ZuluSCSI/ZuluSCSI-Blaster-Ultra-Lite-OSHW/README.md

ZuluSCSI® Blaster Ultra Lite OSHW
================

This repository contains the KiCAD 10 schematic and PCB design files for an Open Source Hardware variant of the RP2350B-based ZuluSCSI® Blaster 

ZuluSCSI® Ultra Lite OSHW is the worlds first* **_open-source**_ [OSHWA-certified](https://certification.oshwa.org/us002873.html) _Ultra_ SCSI emulator, an open-source alternative to our commercially available ZuluSCSI Blaster, designed with cost efficiency in mind.

ZuluSCSI® Blaster Ultra Lite runs unmodified [ZuluSCSI Blaster firmware](https://github.com/ZuluSCSI/ZuluSCSI-firmware/releases)

Pre-prepared gerbers and BoM files are available in [the release section](https://github.com/ZuluSCSI/ZuluSCSI-Blaster-Ultra-Lite-OSHW/releases/tag/Rev2026b)

License
----------------------------

This hardware design is licensed under the terms of the [strongly reciprocal CERN OHL-S V2 license](https://ohwr.org/cern_ohl_s_v2.txt) 

ZuluSCSI® is a registered trademark of Rabbit Hole Computing, and may not be used commercially without the express written consent of Rabbit Hole Computing. Individuals producing ZuluSCSI boards for personal use are hereby granted permission to use the ZuluSCSI trademark in a noncommercial capacity.

_Any_ use of the ZuluSCSI® [registered trademark](https://tmsearch.uspto.gov/search/search-results/97574699) in a **commercial** context requires **prior written consent from Rabbit Hole Computing.**

ZuluSCSI Blaster Ultra Lite OSHW

*That we know of :)
