ZuluSCSI/ZuluSCSI-Blaster-Ultra-Lite-OSHW/certification-mark-US002873-stacked.png

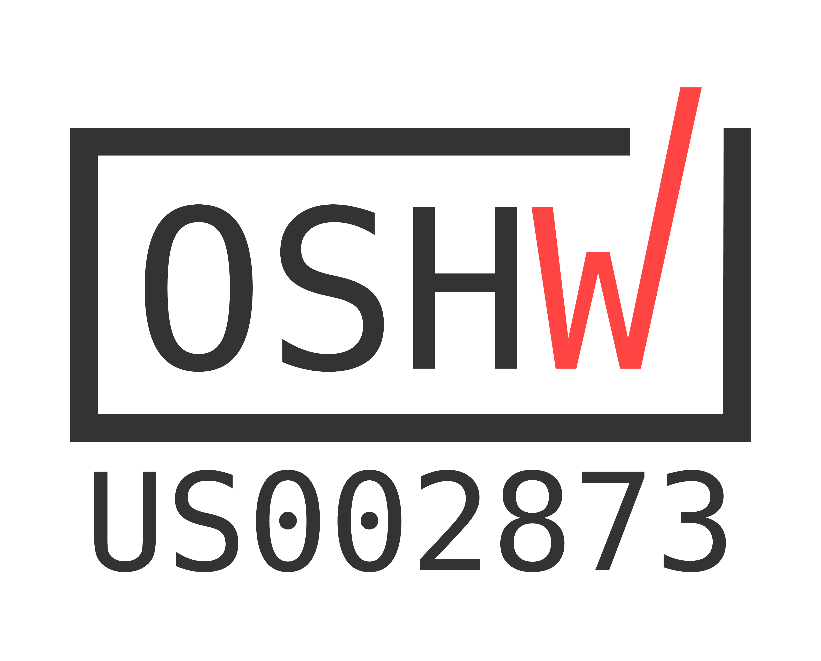
certification-mark-US002873-stacked.png
