ZuluSCSI/ZuluSCSI-Blaster-Ultra-Lite-OSHW/ZuluSCSI_Blaster_Ultra_Lite_OSHW_Rev2026b-render-bottom.png

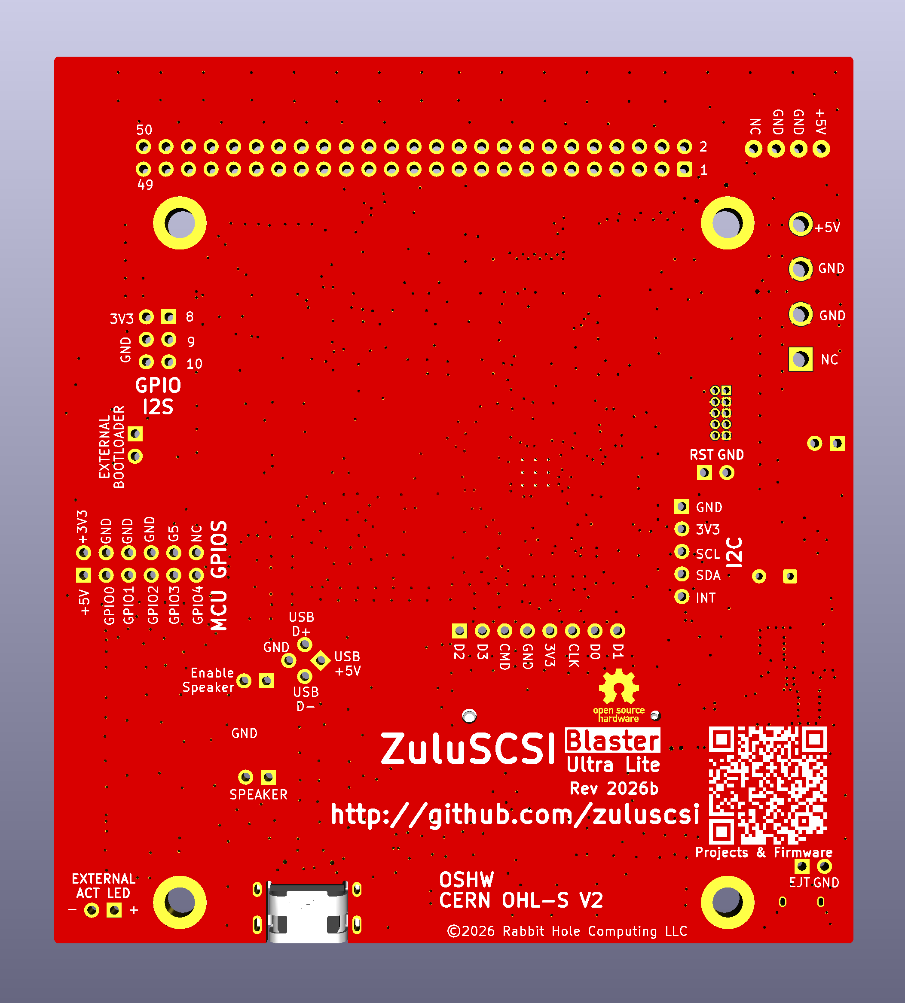
ZuluSCSI_Blaster_Ultra_Lite_OSHW_Rev2026b-render-bottom.png
