ZuluSCSI/ZuluSCSI-Blaster-Ultra-Lite-OSHW/kicad_libs/3D-models/c-3-1761605-5-b-3d.stp

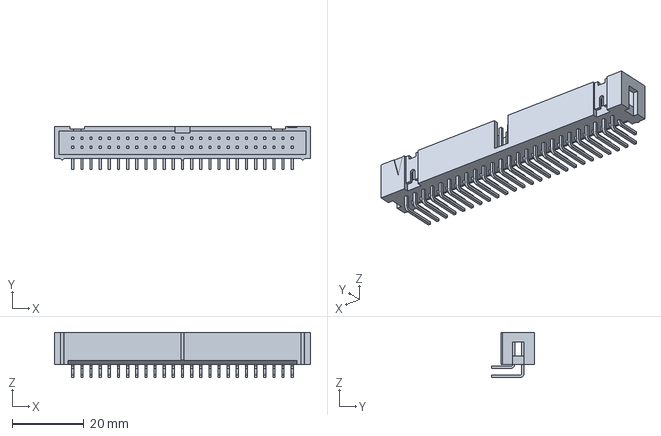
[picture p3: CAD file, 2026-11-06]
kicad_libs/3D-models/c-3-1761605-5-b-3d.stp
71.1 x 11.8 x 12.5 mm
