ZuluSCSI/ZuluSCSI-Blaster-Ultra-Lite-OSHW/kicad_libs/3D-models/RP2350_QFN80.step

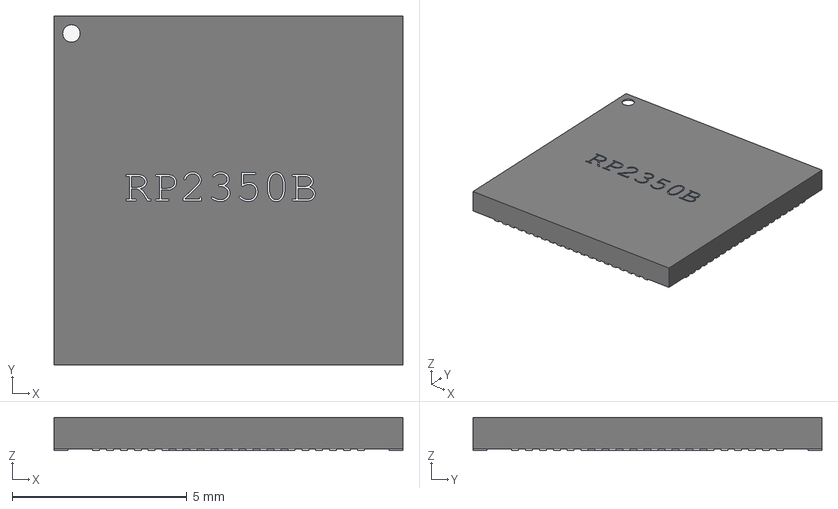
[picture p4: CAD file, 2026-11-06]
kicad_libs/3D-models/RP2350_QFN80.step
10.0 x 10.0 x 0.95 mm
