ZuluSCSI/ZuluSCSI-Blaster-Ultra-Lite-OSHW/kicad_libs/3D-models/molex-vert-c-350424-1-t-3d.stp

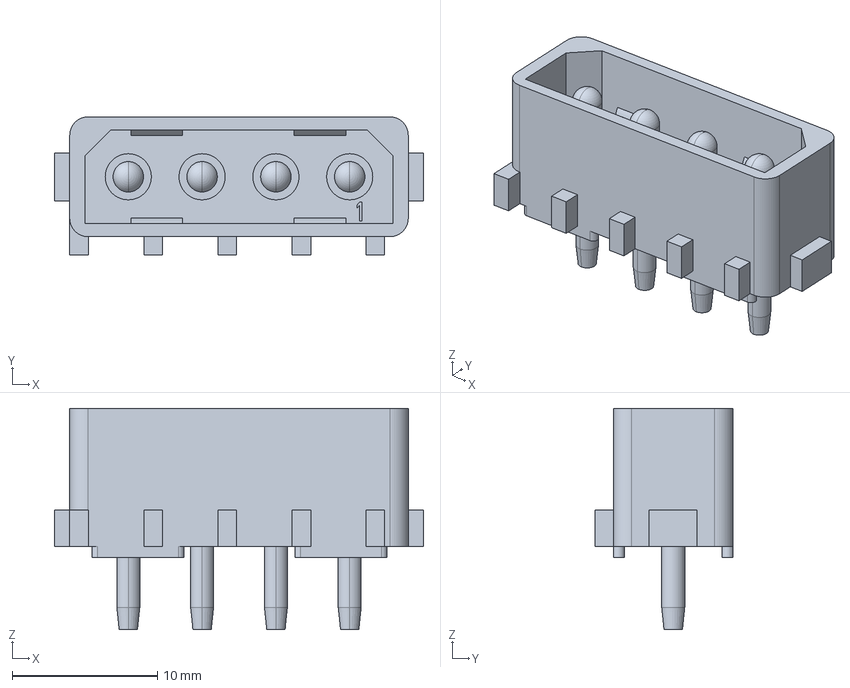
[picture p5: CAD file, 2026-11-06]
kicad_libs/3D-models/molex-vert-c-350424-1-t-3d.stp
25.4 x 9.53 x 15.2 mm
