ZuluSCSI/ZuluSCSI-Blaster-Ultra-Lite-OSHW/kicad_libs/3D-models/70543-0003.stp

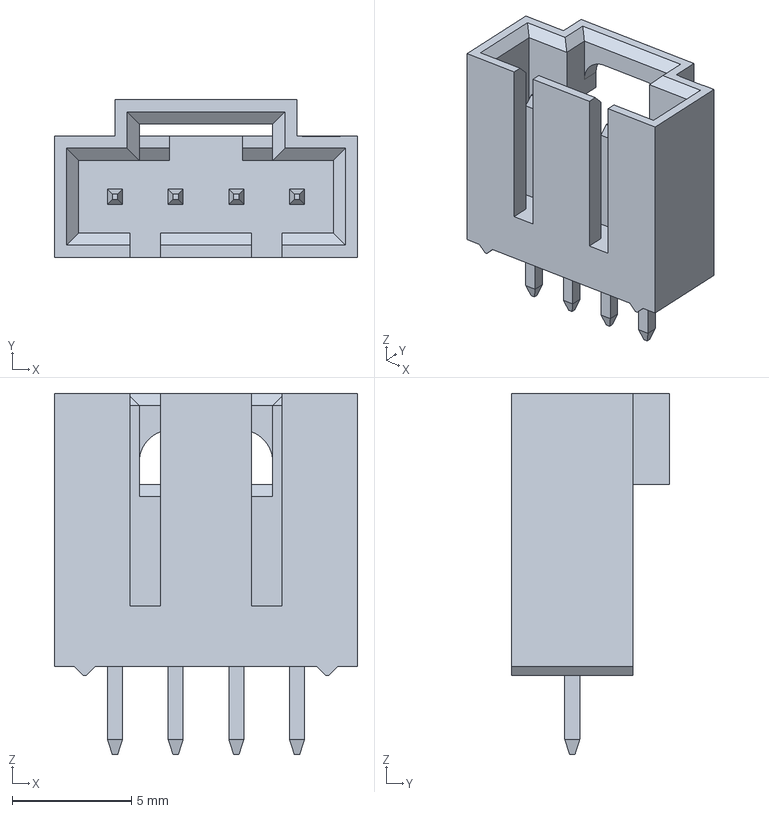
[picture p6: CAD file, 2026-11-06]
kicad_libs/3D-models/70543-0003.stp
12.7 x 6.60 x 15.1 mm
