ZuluSCSI/ZuluSCSI-Blaster-Ultra-Lite-OSHW/kicad_libs/3D-models/705530003.step

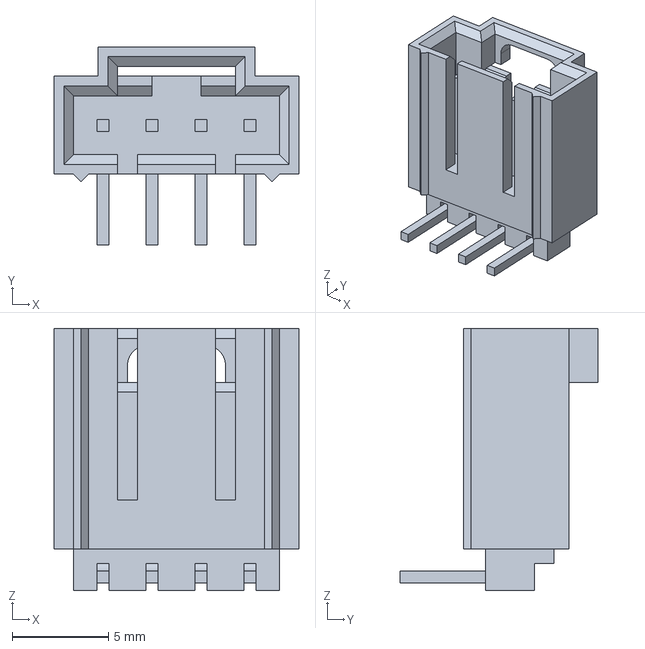
[picture p7: CAD file, 2026-11-06]
kicad_libs/3D-models/705530003.step
12.7 x 10.3 x 13.6 mm
