ZuluSCSI/ZuluSCSI-Blaster-Ultra-Lite-OSHW/ZuluSCSI_Blaster_Ultra_Lite.kicad_pcb

## KiCad design ZuluSCSI_Blaster_Ultra_Lite.kicad_pcb (2026-11-06)

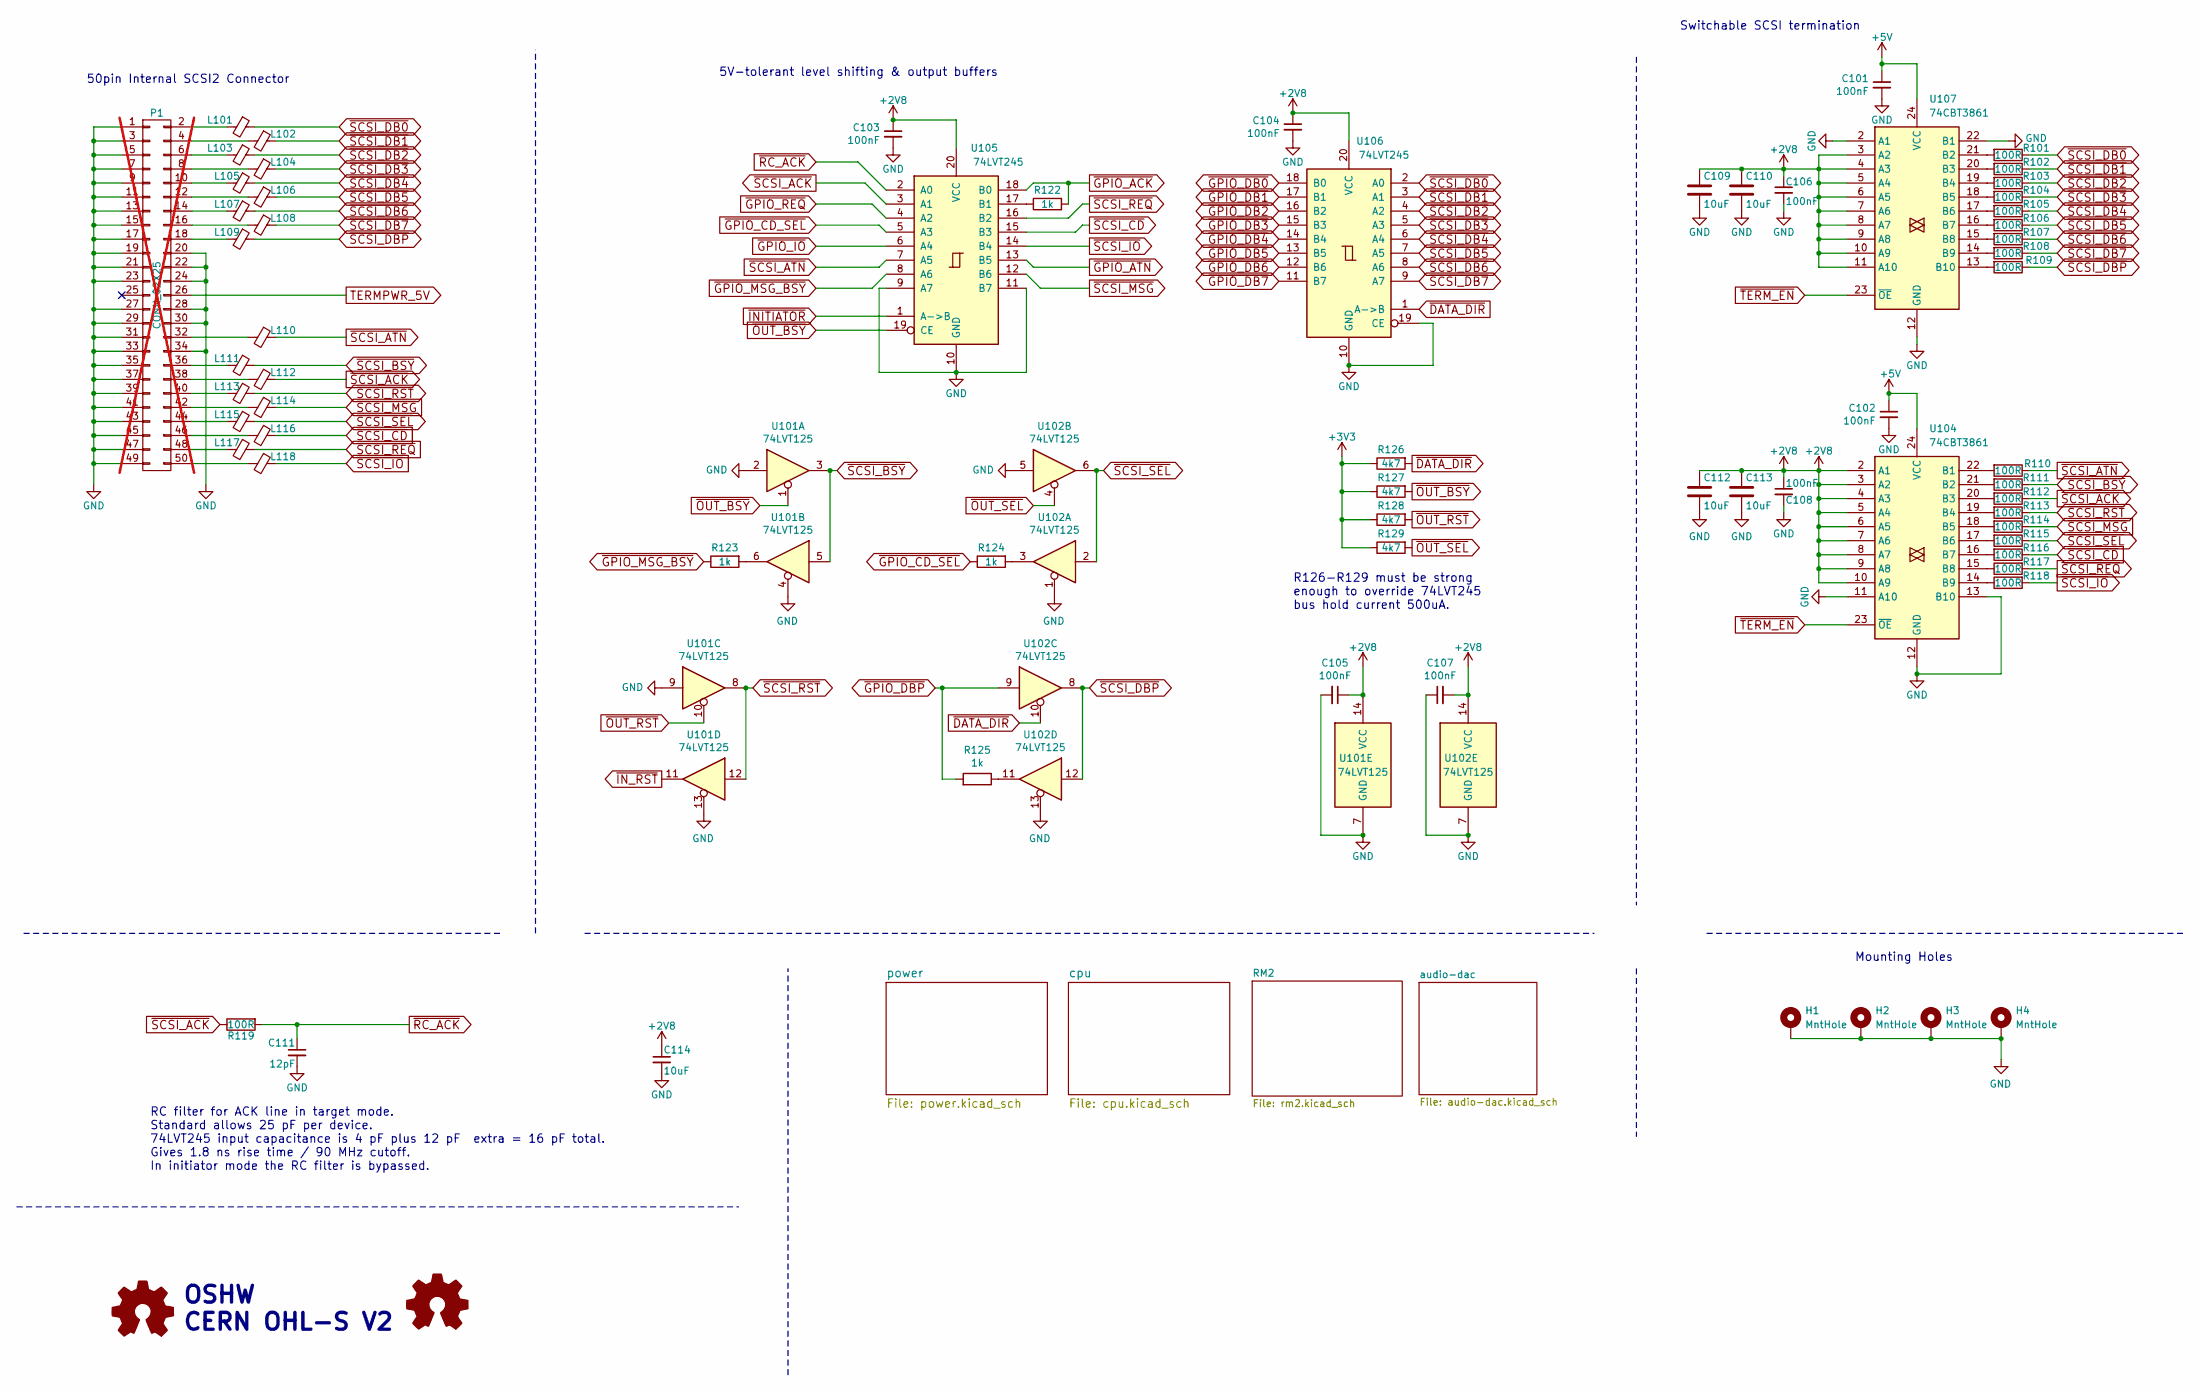
[picture p8: schematic ZuluSCSI_Blaster_Ultra_Lite.kicad_sch, ZuluSCSI Blaster Ultra Lite OSHW]

Parts:
C101, C102, C103, C104, C105, C106, C107, C108: 100nF; C_0402_1005Metric; PartNumber CL05B104KO5NNNC; LCSC C1525
C109, C110, C112, C113: 10uF; C_0805_2012Metric; Voltage Rating 16V; PartNumber CL21A106KAYNNNE; LCSC C15850
C111: 12pF; C_0603_1608Metric; PartNumber C0603C120J5GAC7867; LCSC C38523
C114: 10uF; C_0805_2012Metric; PartNumber CL21A106KAYNNNE; LCSC C15850
H1, H2, H3, H4: MntHole; Screw_Hole_M3
L101, L102, L103, L104, L105, L106, L107, L108, L109, L110, L111, L112, L113, L114, L115, L116, L117, L118: Ferrite_Bead_Small; L_0603_1608Metric; PartNumber BLM18PG330SN1D; LCSC C88984
P1: CONN_02X25; IDC-Header_2x25_P2.54mm_Horizontal; PartNumber SBH11-PBPC-D25-RA-BK; LCSC C19193830; not fitted
R101, R102, R103, R104, R105, R106, R107, R108, R109, R110, R111, R112, R113, R114, R115, R116, R117, R118, R119: 100R; R_0603_1608Metric; PartNumber RC0603FR-07100RL; LCSC C22775
R122, R123, R124, R125: 1k; R_0603_1608Metric; PartNumber RC0603JR-071KL; LCSC C21190
R126, R127, R128, R129: 4k7; R_0603_1608Metric; PartNumber RC0603JR-074K7L; LCSC C23162
SYM1, SYM2: Logo_Open_Hardware_Small; OSHW-Logo_5.7x6mm_Copper_SolderMask
U101, U102: 74LVT125; SSOP_TSSOP-14_4.4x5mm_Pitch0.65mm_PCBWay-MaskClearance0.22mm; PartNumber SN74LVT125PWR; LCSC C7042
U104, U107: 74CBT3861; TSSOP-24_4.4x7.8mm_P0.65mm; PartNumber SN74CBT3861PWR; JLCPCBCORRECT 0;0;-90
U105, U106: 74LVT245; SSOP_TSSOP-20_5.3x7.2mm_P0.65mm; PartNumber SN74LVTH245APWR; LCSC C2652121

Connections:
+2V8: C103.1, C104.1, C105.1, C106.1, C107.2, C108.1, C109.1, C110.1, C112.1, C113.1, C114.1, U101.14 (VCC), U102.14 (VCC), U104.2 (A1), U104.3 (A2), U104.4 (A3), U104.5 (A4), U104.6 (A5), U104.7 (A6), U104.8 (A7), U104.9 (A8), U104.10 (A9), U105.20 (VCC), U106.20 (VCC), U107.3 (A2), U107.4 (A3), U107.5 (A4), U107.6 (A5), U107.7 (A6), U107.8 (A7), U107.9 (A8), U107.10 (A9), U107.11 (A10); also elsewhere on the board
+3V3: R126.1, R127.1, R128.1, R129.1; also elsewhere on the board
+5V: C101.1, C102.1, U104.24 (VCC), U107.24 (VCC); also elsewhere on the board
GND: C101.2, C102.2, C103.2, C104.2, C105.2, C106.2, C107.1, C108.2, C109.2, C110.2, C111.2, C112.2, C113.2, C114.2, H1.1 (1_1), H2.1 (1_1), H3.1 (1_1), H4.1 (1_1), P1.1, P1.3, P1.5, P1.7, P1.9, P1.11, P1.13, P1.15, P1.17, P1.19, P1.20, P1.21, P1.22, P1.23, P1.24, P1.27, P1.28, P1.29, P1.30, P1.31, P1.33, P1.34, P1.35, P1.37, P1.39, P1.41, P1.43, P1.45, P1.47, P1.49, U101.2, U101.4, U101.7 (GND), U101.9, U101.13, U102.1, U102.5, U102.7 (GND), U102.13, U104.11 (A10), U104.12 (GND), U104.13 (B10), U105.9 (A7), U105.10 (GND), U105.11 (B7), U106.10 (GND), U106.19 (CE), U107.2 (A1), U107.12 (GND), U107.22 (B1); also elsewhere on the board
unnamed: L101.2, P1.2
unnamed: L102.2, P1.4
unnamed: L103.2, P1.6
unnamed: L104.2, P1.8
unnamed: L105.2, P1.10
unnamed: L106.2, P1.12
unnamed: L107.2, P1.14
unnamed: L108.2, P1.16
unnamed: L109.2, P1.18
unnamed: L110.2, P1.32
unnamed: L111.2, P1.36
unnamed: L112.2, P1.38
unnamed: L113.2, P1.40
unnamed: L114.2, P1.42
unnamed: L115.2, P1.44
unnamed: L116.2, P1.46
unnamed: L117.2, P1.48
unnamed: L118.2, P1.50
unnamed: R123.2, U101.6
unnamed: R124.2, U102.3
unnamed: R125.1, U102.11
unnamed: R110.2, U104.22 (B1)
unnamed: R111.2, U104.21 (B2)
unnamed: R112.2, U104.20 (B3)
unnamed: R113.2, U104.19 (B4)
unnamed: R114.2, U104.18 (B5)
unnamed: R115.2, U104.17 (B6)
unnamed: R116.2, U104.16 (B7)
unnamed: R117.1, U104.15 (B8)
unnamed: R118.1, U104.14 (B9)
unnamed: R122.1, U105.17 (B1)
unnamed: R101.2, U107.21 (B2)
unnamed: R102.2, U107.20 (B3)
unnamed: R103.2, U107.19 (B4)
unnamed: R104.2, U107.18 (B5)
unnamed: R105.2, U107.17 (B6)
unnamed: R106.2, U107.16 (B7)
unnamed: R107.2, U107.15 (B8)
unnamed: R108.2, U107.14 (B9)
unnamed: R109.2, U107.13 (B10)
TERMPWR_5V: P1.26; also elsewhere on the board
~DATA_DIR: R126.2, U102.10, U106.1 (A->B); also elsewhere on the board
~GPIO_ACK: R122.2, U105.18 (B0); also elsewhere on the board
~GPIO_ATN: U105.13 (B5); also elsewhere on the board
~GPIO_CD_SEL: R124.1, U105.5 (A3); also elsewhere on the board
~GPIO_DB0: U106.18 (B0); also elsewhere on the board
~GPIO_DB1: U106.17 (B1); also elsewhere on the board
~GPIO_DB2: U106.16 (B2); also elsewhere on the board
~GPIO_DB3: U106.15 (B3); also elsewhere on the board
~GPIO_DB4: U106.14 (B4); also elsewhere on the board
~GPIO_DB5: U106.13 (B5); also elsewhere on the board
~GPIO_DB6: U106.12 (B6); also elsewhere on the board
~GPIO_DB7: U106.11 (B7); also elsewhere on the board
~GPIO_DBP: R125.2, U102.9; also elsewhere on the board
~GPIO_IO: U105.6 (A4); also elsewhere on the board
~GPIO_MSG_BSY: R123.1, U105.8 (A6); also elsewhere on the board
~GPIO_REQ: U105.4 (A2); also elsewhere on the board
~INITIATOR: U105.1 (A->B); also elsewhere on the board
~IN_RST: U101.11; also elsewhere on the board
~OUT_BSY: R127.2, U101.1, U105.19 (CE); also elsewhere on the board
~OUT_RST: R128.2, U101.10; also elsewhere on the board
~OUT_SEL: R129.2, U102.4; also elsewhere on the board
~RC_ACK: C111.1, R119.2, U105.2 (A0)
~SCSI_ACK: L112.1, R112.1, R119.1, U105.3 (A1)
~SCSI_ATN: L110.1, R110.1, U105.7 (A5)
~SCSI_BSY: L111.1, R111.1, U101.3, U101.5
~SCSI_CD: L116.1, R116.1, U105.15 (B3)
~SCSI_DB0: L101.1, R101.1, U106.2 (A0)
~SCSI_DB1: L102.1, R102.1, U106.3 (A1)
~SCSI_DB2: L103.1, R103.1, U106.4 (A2)
~SCSI_DB3: L104.1, R104.1, U106.5 (A3)
~SCSI_DB4: L105.1, R105.1, U106.6 (A4)
~SCSI_DB5: L106.1, R106.1, U106.7 (A5)
~SCSI_DB6: L107.1, R107.1, U106.8 (A6)
~SCSI_DB7: L108.1, R108.1, U106.9 (A7)
~SCSI_DBP: L109.1, R109.1, U102.8, U102.12
~SCSI_IO: L118.1, R118.2, U105.14 (B4)
~SCSI_MSG: L114.1, R114.1, U105.12 (B6)
~SCSI_REQ: L117.1, R117.2, U105.16 (B2)
~SCSI_RST: L113.1, R113.1, U101.8, U101.12
~SCSI_SEL: L115.1, R115.1, U102.2, U102.6
~TERM_EN: U104.23 (~OE), U107.23 (~OE); also elsewhere on the board

Notes on the sheet:
Switchable SCSI termination
R126-R129 must be strong enough to override 74LVT245 bus hold current 500uA.
5V-tolerant level shifting & output buffers
50pin Internal SCSI2 Connector
Mounting Holes
OSHW CERN OHL-S V2
RC filter for ACK line in target mode. Standard allows 25 pF per device. 74LVT245 input capacitance is 4 pF plus 12 pF extra = 16 pF total. Gives 1.8 ns rise time / 90 MHz cutoff. In initiator mode the RC filter is bypassed.

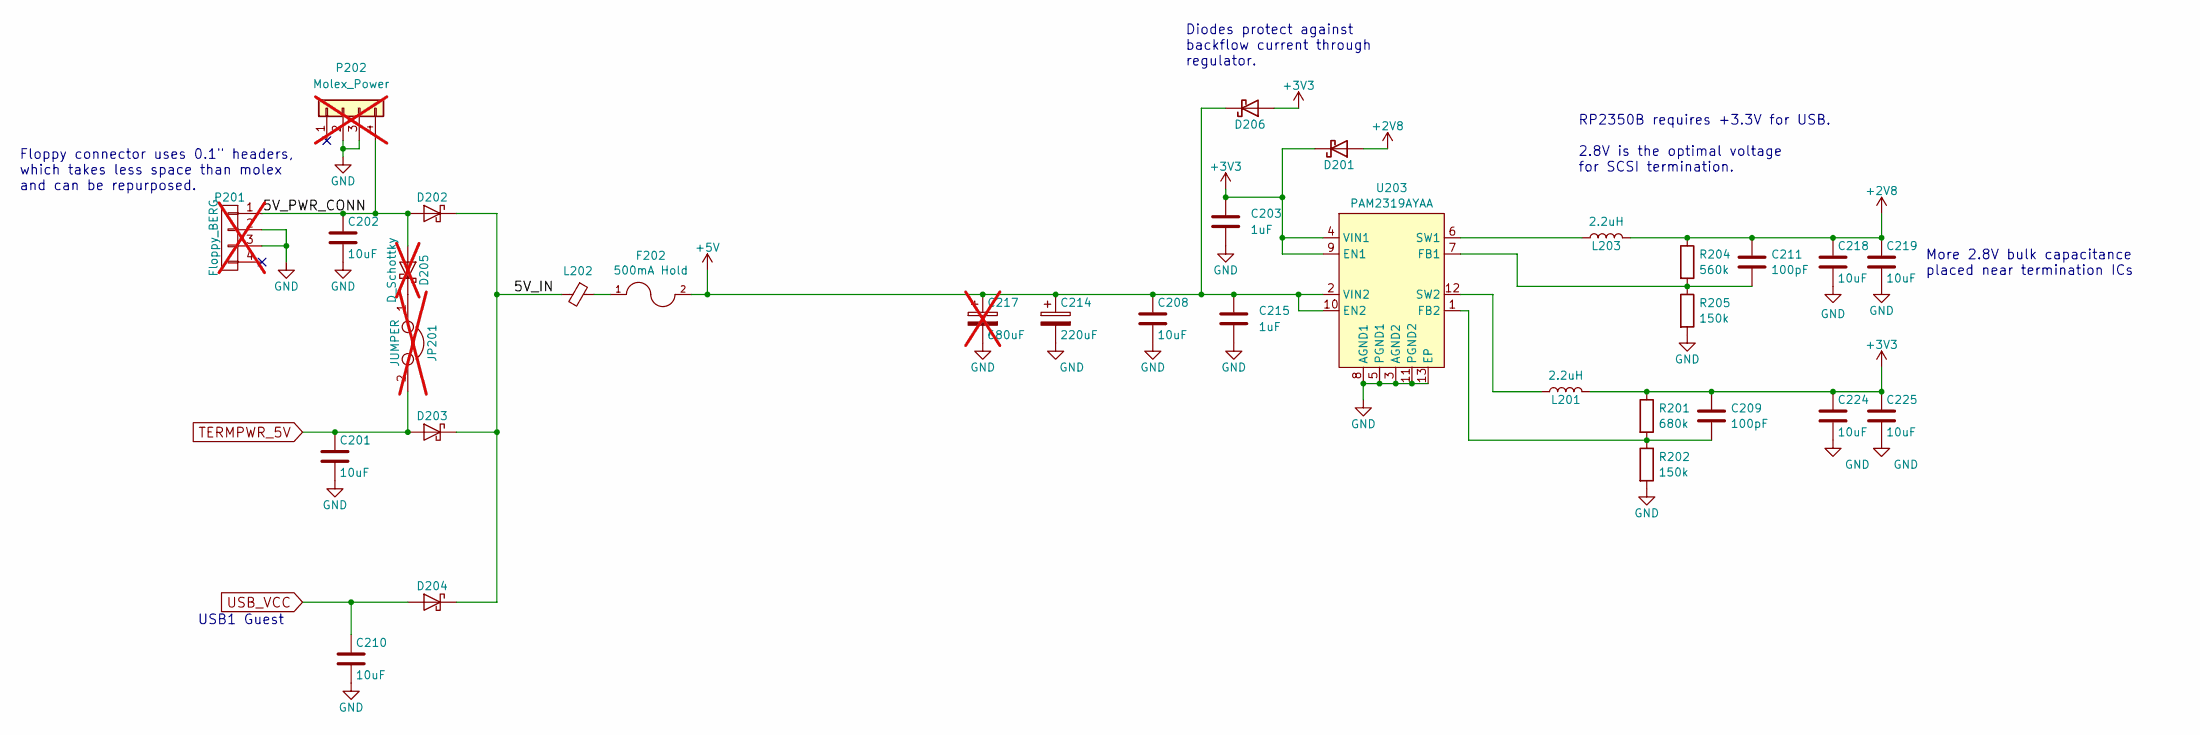
[picture p9: schematic power.kicad_sch, ZuluSCSI Blaster Ultra Lite OSHW]

Parts:
C201, C202, C210: 10uF; C_0805_2012Metric; PartNumber CL21A106KAYNNNE; LCSC C15850
C203, C215: 1uF; C_0402_1005Metric; PartNumber CL05A105KA5NQNC; LCSC C52923
C208, C218, C219, C224, C225: 10uF; C_0805_2012Metric; Voltage Rating 16V; PartNumber CL21A106KAYNNNE; LCSC C15850
C209, C211: 100pF; C_0402_1005Metric; PartNumber CC0402JRNPO9BN101; LCSC C106200
C214: 220uF; CP_Elec_6.3x7.7; PartNumber UUD1C221MCL1GS; LCSC C2887273
C217: 680uF; CP_Radial_D8.0mm_P3.50mm; Voltage Rating 10V; PartNumber EEUFR1A681; LCSC N/A; not fitted
D201, D202, D203, D204, D206: D_Schottky; D_SOD-123; PartNumber MBRX120LF-TP; LCSC C8598
D205: D_Schottky; D_SOD-123; PartNumber MBRX120LF-TP; LCSC C8598; not fitted
F202: 500mA Hold; Fuse_1206_3216Metric; PartNumber 0ZCJ0050FF2G; LCSC C43379
JP201: JUMPER; PinHeader_1x02_P2.54mm_Vertical; LCSC N/A; not fitted
L201, L203: 2.2uH; Inductor_1008; PartNumber DFE252012P-2R2M=P2; LCSC C86092
L202: Ferrite_Bead_Small; L_0603_1608Metric; PartNumber BLM18PG330SN1D; LCSC C88984
P201: Floppy_BERG; floppy-berg; PartNumber 171826-4; digikey A112643-ND; not fitted
P202: Molex_Power; molex-vert-TE_350424-1; PartNumber 350211-1; JLCPCB_IGNORE do not fit; not fitted
R201: 680k; R_0402_1005Metric; PartNumber RC0402FR-07680KL; LCSC C4131
R202, R205: 150k; R_0402_1005Metric; PartNumber RMCF0402FT150K; LCSC C93947
R204: 560k; R_0402_1005Metric; PartNumber RC0402FR-07560KL; LCSC C132339
U203: PAM2319AYAA; WDFN-12-1EP_3x3mm_P0.45mm_EP1.7x2.5mm; PartNumber PAM2319AYAA; LCSC C2071057

Connections:
+2V8: C211.1, C218.1, C219.1, D201.2 (A), L203.2, R204.1; also elsewhere on the board
+3V3: C203.1, C209.1, C224.1, C225.1, D201.1 (K), D206.2 (A), L201.2, R201.1, U203.4 (VIN1), U203.9 (EN1); also elsewhere on the board
+5V: C208.1, C214.1, C215.1, C217.1, D206.1 (K), F202.2, U203.2 (VIN2), U203.10 (EN2); also elsewhere on the board
/power/5V_IN: D202.1 (K), D203.1 (K), D204.1 (K), L202.2
/power/5V_PWR_CONN: C202.1, D202.2 (A), D205.2 (A), P201.1, P202.4
GND: C201.2, C202.2, C203.2, C208.2, C210.2, C214.2, C215.2, C217.2, C218.2, C219.2, C224.2, C225.2, P201.2, P201.3, P202.2, P202.3, R202.2, R205.2, U203.3 (AGND2), U203.5 (PGND1), U203.8 (AGND1), U203.11 (PGND2), U203.13 (EP); also elsewhere on the board
unnamed: D205.1 (K), JP201.1
unnamed: F202.1, L202.1
unnamed: C211.2, R204.2, R205.1, U203.7 (FB1)
unnamed: C209.2, R201.2, R202.1, U203.1 (FB2)
unnamed: L203.1, U203.6 (SW1)
unnamed: L201.1, U203.12 (SW2)
TERMPWR_5V: C201.1, D203.2 (A), JP201.2; also elsewhere on the board
USB_VCC: C210.1, D204.2 (A); also elsewhere on the board

Notes on the sheet:
More 2.8V bulk capacitance placed near termination ICs
RP2350B requires +3.3V for USB. 2.8V is the optimal voltage for SCSI termination.
Floppy connector uses 0.1" headers, which takes less space than molex and can be repurposed.
USB1 Guest
Diodes protect against backflow current through regulator.

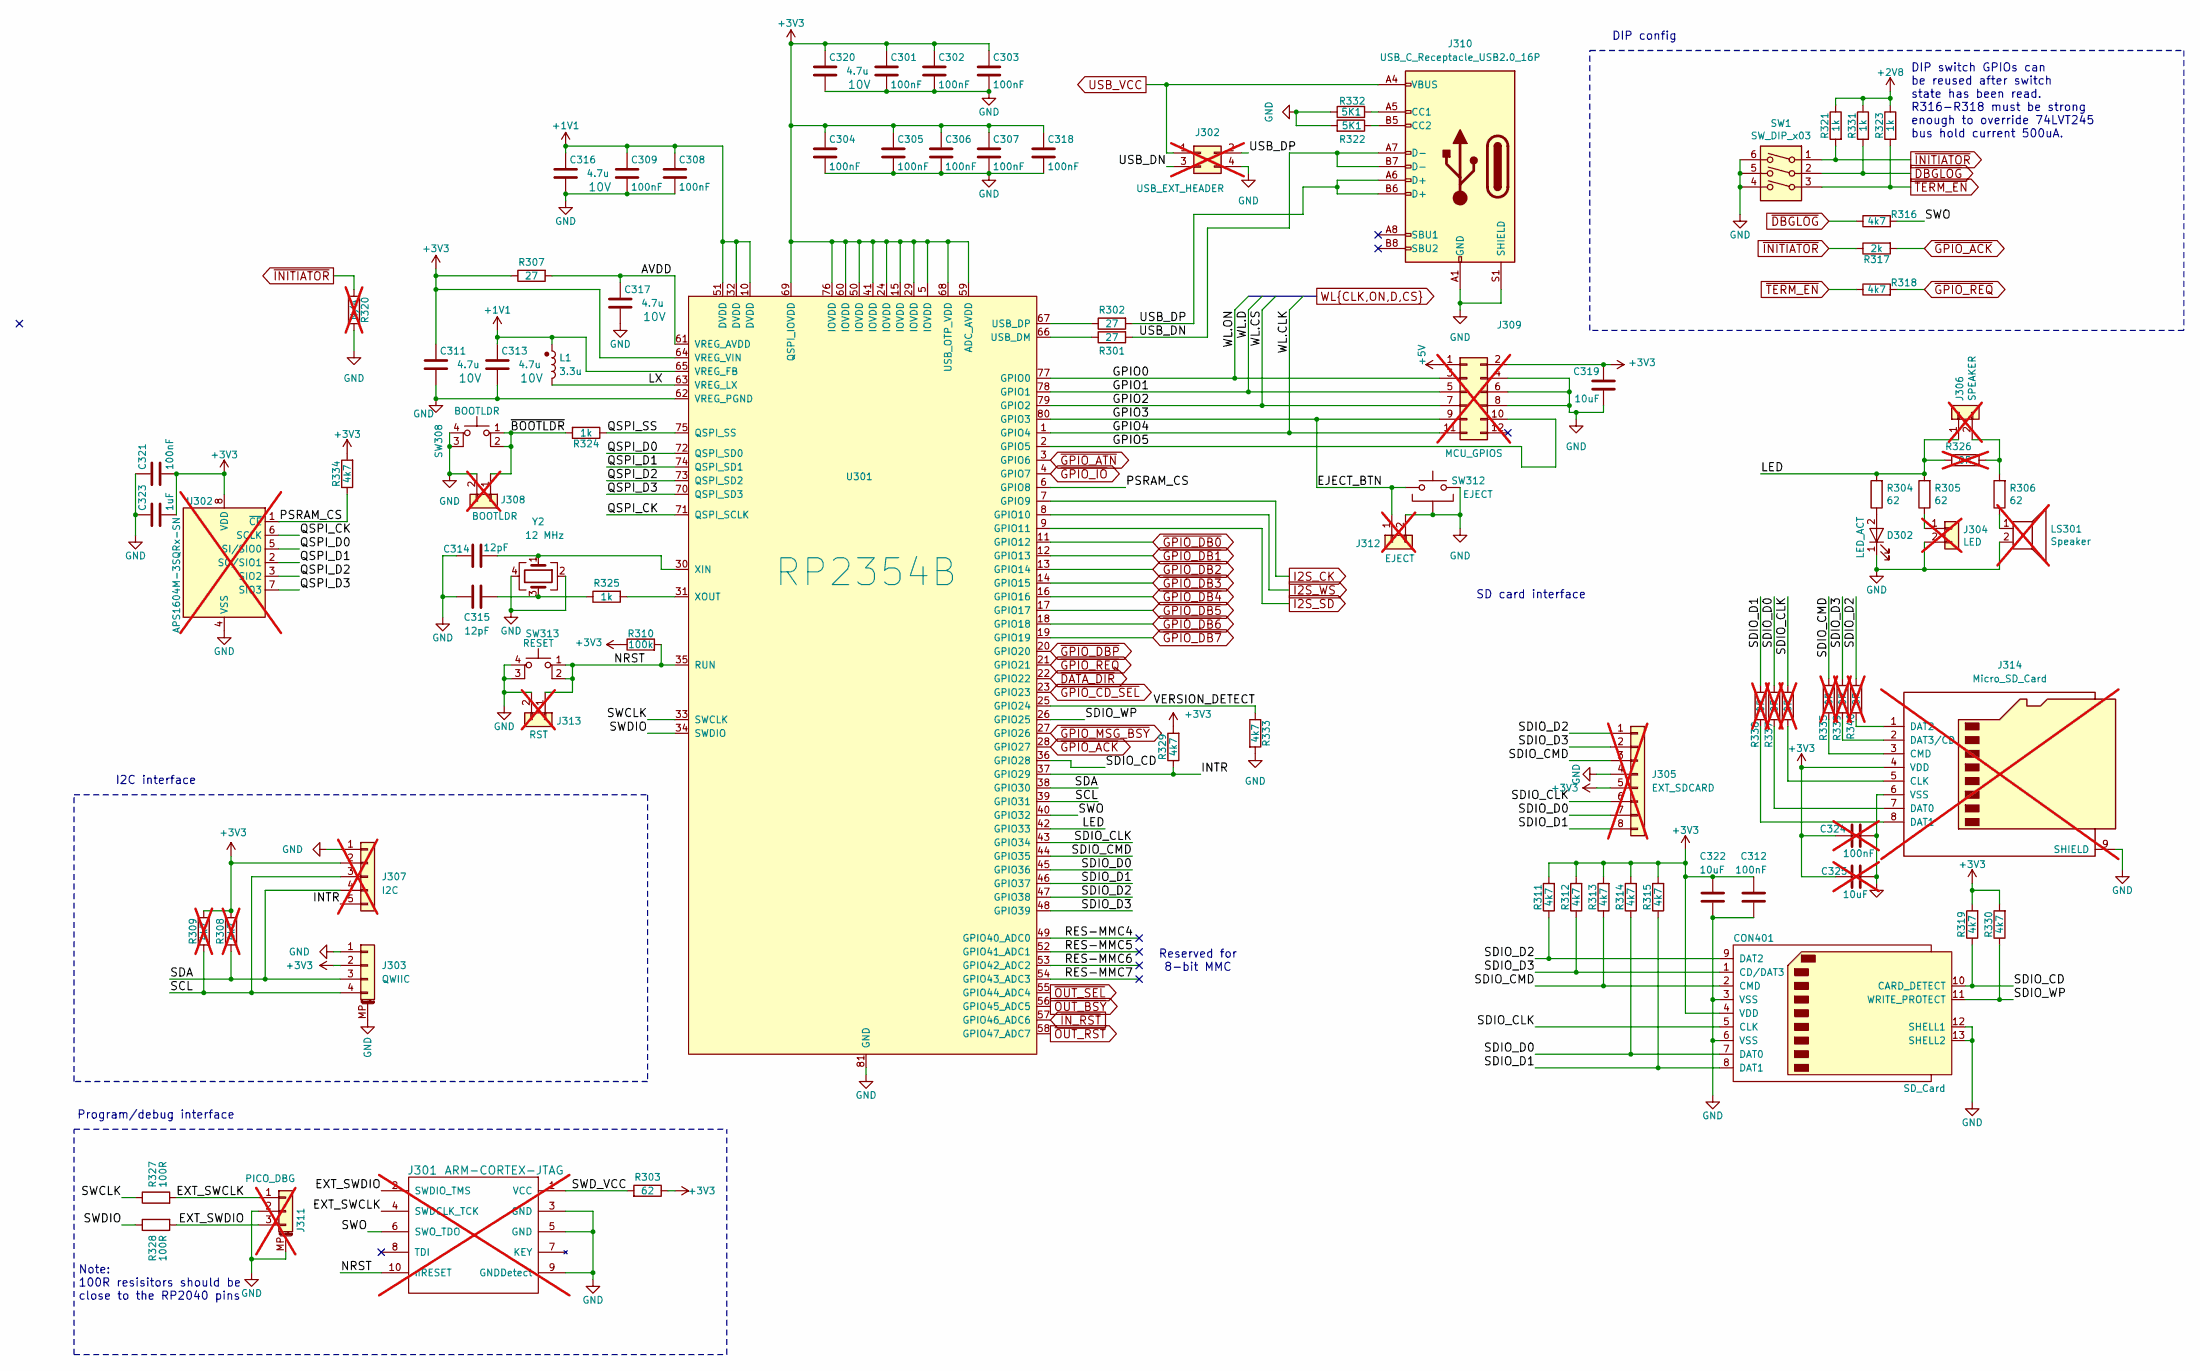
[picture p10: schematic cpu.kicad_sch, ZuluSCSI Blaster Ultra Lite OSHW]

Parts:
C301, C302, C303, C304, C305, C306, C307, C308, C309, C312, C318, C321: 100nF; C_0402_1005Metric; PartNumber CL05B104KO5NNNC; LCSC C1525
C311, C313: 4.7u; C_0402_1005Metric_small_pads; Voltage 10V; PartNumber GRM155R61A475MEAAD; LCSC C335105
C314, C315: 12pF; C_0402_1005Metric; PartNumber GCQ1555C1H120GB01D; LCSC C2235030
C316, C317, C320: 4.7u; C_0402_1005Metric; Voltage 10V; PartNumber GRM155R61A475MEAAD; LCSC C335105
C319, C322: 10uF; C_0805_2012Metric; PartNumber CL21A106KAYNNNE; LCSC C15850
C323: 1uF; C_0603_1608Metric; PartNumber UMK107BJ105KA-T; LCSC C15849
C324: 100nF; C_0603_1608Metric; PartNumber CL10B104KB8NNWC; LCSC C14663; not fitted
C325: 10uF; C_0805_2012Metric; PartNumber CL21B106KOQNNNE; LCSC C95841; not fitted
CON401: SD_Card; SD-SMD_SD-101; PartNumber SD-101; LCSC C266601
D302: LED_ACT; LED_0805_2012Metric; LCSC C434435
J301: ARM-CORTEX-JTAG; SAMTEC_FTSH-105-01-LM-D-K; LCSC N/A; not fitted
J302: USB_EXT_HEADER; PinHeader_2x02_P2.54mm_Vertical; JLCPCB_IGNORE do not fit; not fitted
J303: QWIIC; JST_SH_BM04B-SRSS-TB_1x04-1MP_P1.00mm_Vertical; LCSC C160390
J304: LED; PinHeader_1x02_P2.54mm_Vertical; LCSC N/A; not fitted
J305: EXT_SDCARD; PinHeader_1x08_P2.54mm_Vertical; JLCPCB_IGNORE do not fit; not fitted
J306: SPEAKER; PinHeader_1x02_P2.54mm_Vertical; LCSC N/A; not fitted
J307: I2C; PinHeader_1x05_P2.54mm_Vertical; JLCPCB_IGNORE do not fit; not fitted
J308: BOOTLDR; PinHeader_1x02_P2.54mm_Vertical; LCSC N/A; not fitted
J309: MCU_GPIOS; PinSocket_2x06_P2.54mm_Vertical; JLCPCB_IGNORE do not fit; not fitted
J310: USB_C_Receptacle_USB2.0_16P; USB-C-SMD_SHOU_TYPE-C-16P-CB1.6; LCSC C2906290
J311: PICO_DBG; JST_SH_BM03B-SRSS-TB_1x03-1MP_P1.00mm_Vertical; LCSC C160389; not fitted
J312: EJECT; PinHeader_1x02_P2.54mm_Vertical; LCSC N/A; not fitted
J313: RST; PinHeader_1x02_P2.54mm_Vertical; LCSC N/A; not fitted
J314: Micro_SD_Card; SD_FLIP_CONN_47219-2001_MOL; PartNumber 472192001; LCSC C164170; not fitted
L1: 3.3u; L_pol_2016; PartNumber AOTA-B201610S3R3-101-T; digikey 535-AOTA-B201610S3R3-101-TTR-ND
LS301: Speaker; PinHeader_1x02_P2.54mm_Vertical; LCSC N/A; not fitted
R301, R302, R307: 27; R_0402_1005Metric; PartNumber RC0402FR-0727RL; LCSC C138021
R303, R304, R305, R306: 62; R_0603_1608Metric; PartNumber RC0603FR-0762RL; LCSC C25252
R308, R309: 4k7; R_0603_1608Metric; PartNumber RC0603JR-074K7L; LCSC C23162; not fitted
R310: 100k; R_0603_1608Metric; PartNumber RC0603FR-07100KL; LCSC C25803
R311, R312, R313, R314, R315, R316, R318, R319, R329, R330, R333, R334: 4k7; R_0603_1608Metric; PartNumber RC0603JR-074K7L; LCSC C23162
R317: 2k; R_0603_1608Metric; PartNumber RC0603FR-072KL; LCSC C22975
R320: N/A; R_0402_1005Metric; LCSC N/A; not fitted
R321, R323, R324, R331: 1k; R_0603_1608Metric; PartNumber RC0603JR-071KL; LCSC C21190
R322, R332: 5K1; R_0603_1608Metric; LCSC C23186
R325: 1k; R_0402_1005Metric; PartNumber RC0402FR-071KL; LCSC C106235
R326: 0R; R_0603_1608Metric; LCSC N/A; not fitted
R327, R328: 100R; R_0603_1608Metric; PartNumber RC0603FR-07100RL; LCSC C22775
R335, R336, R337, R338, R339, R340: 0R; R_0603_1608Metric; PartNumber RC0603FR-070RL; LCSC C21189; not fitted
SW1: SW_DIP_x03; SW_DIP_SPSTx03_Slide_6.7x9.18mm_W8.61mm_P2.54mm_LowProfile; PartNumber 219-3MSTR; LCSC C319040
SW308: BOOTLDR; SW-SMD_4P-L5.1-W5.1-P3.70-LS6.5-TL_H1.5; PartNumber PTS526SM15SMTR2 LFS; LCSC C318884
SW312: EJECT; SW-SMD_GT-TC108A-H034-L1S; LCSC C22396279
SW313: RESET; SW-SMD_4P-L5.1-W5.1-P3.70-LS6.5-TL_H1.5; PartNumber PTS526SM15SMTR2 LFS; LCSC C318884
U301: RP2354B; QFN-80-1EP_10x10mm_P0.4mm_EP3.4x3.4mm_ThermalVias; PartNumber RP2354B; LCSC C39843328
U302: APS1604M-3SQRx-SN; SOIC-8_3.9x4.9mm_P1.27mm; PartNumber APS1604M-3SQR-SN; LCSC C18214056; not fitted
Y2: 12 MHz; Crystal_SMD_3225-4Pin_3.2x2.5mm; PartNumber ABM8-272-T3; LCSC C20625731

Connections:
+1V1: C308.1, C309.1, C313.1, C316.1, L1.1, U301.10 (DVDD), U301.32 (DVDD), U301.51 (DVDD), U301.65 (VREG_FB)
+2V8: R321.1, R323.1, R331.1; also elsewhere on the board
+3V3: C301.1, C302.1, C303.1, C304.1, C305.1, C306.1, C307.1, C311.1, C312.2, C318.1, C319.1, C320.1, C321.2, C322.2, C323.2, C324.2, C325.2, CON401.4 (VDD), J303.2, J305.5, J307.2, J309.2, J314.4 (VDD), R303.1, R307.1, R308.2, R309.2, R310.1, R311.2, R312.2, R313.2, R314.2, R315.2, R319.2, R329.2, R330.2, R334.2, U301.5 (IOVDD), U301.15 (IOVDD), U301.24 (IOVDD), U301.29 (IOVDD), U301.41 (IOVDD), U301.50 (IOVDD), U301.59 (ADC_AVDD), U301.60 (IOVDD), U301.64 (VREG_VIN), U301.68 (USB_OTP_VDD), U301.69 (QSPI_IOVDD), U301.76 (IOVDD), U302.8 (VDD); also elsewhere on the board
+5V: J309.1; also elsewhere on the board
/cpu/AVDD: C317.1, R307.2, U301.61 (VREG_AVDD)
/cpu/EJECT_BTN: J309.9, J312.1, SW312.2, U301.80 (GPIO3)
/cpu/EXT_SWCLK: J301.4 (SWDCLK_TCK), J311.1, R327.2
/cpu/EXT_SWDIO: J301.2 (SWDIO_TMS), J311.3, R328.2
/cpu/GPIO5: J309.10, U301.2 (GPIO5)
/cpu/INTR: J307.5, R329.1, U301.37 (GPIO29)
/cpu/LED: J306.1, R304.2, R305.2, R326.2, U301.42 (GPIO33)
/cpu/LX: L1.2, U301.63 (VREG_LX)
/cpu/NRST: J301.10 (nRESET), J313.1, R310.2, SW313.1, SW313.2, U301.35 (RUN)
/cpu/PSRAM_CS: R334.1, U301.6 (GPIO8), U302.1 (~CE)
/cpu/QSPI_CK: U301.71 (QSPI_SCLK), U302.6 (SCLK)
/cpu/QSPI_D0: U301.72 (QSPI_SD0), U302.5 (SI/SIO0)
/cpu/QSPI_D1: U301.74 (QSPI_SD1), U302.2 (SO/SIO1)
/cpu/QSPI_D2: U301.73 (QSPI_SD2), U302.3 (SIO2)
/cpu/QSPI_D3: U301.70 (QSPI_SD3), U302.7 (SIO3)
/cpu/QSPI_SS: R324.1, U301.75 (QSPI_SS)
/cpu/RES-MMC4: U301.49 (GPIO40_ADC0)
/cpu/RES-MMC5: U301.52 (GPIO41_ADC1)
/cpu/RES-MMC6: U301.53 (GPIO42_ADC2)
/cpu/RES-MMC7: U301.54 (GPIO43_ADC3)
/cpu/SCL: J303.4, J307.3, R309.1, U301.39 (GPIO31)
/cpu/SDA: J303.3, J307.4, R308.1, U301.38 (GPIO30)
/cpu/SDIO_CD: CON401.10 (CARD_DETECT), R319.1, U301.36 (GPIO28)
/cpu/SDIO_CLK: CON401.5 (CLK), J305.6, R336.2, U301.43 (GPIO34)
/cpu/SDIO_CMD: CON401.2 (CMD), J305.3, R313.1, R335.2, U301.44 (GPIO35)
/cpu/SDIO_D0: CON401.7 (DAT0), J305.7, R314.1, R337.2, U301.45 (GPIO36)
/cpu/SDIO_D1: CON401.8 (DAT1), J305.8, R315.1, R338.2, U301.46 (GPIO37)
/cpu/SDIO_D2: CON401.9 (DAT2), J305.1, R311.1, R340.2, U301.47 (GPIO38)
/cpu/SDIO_D3: CON401.1 (CD/DAT3), J305.2, R312.1, R339.2, U301.48 (GPIO39)
/cpu/SDIO_WP: CON401.11 (WRITE_PROTECT), R330.1, U301.26 (GPIO25)
/cpu/SWCLK: R327.1, U301.33 (SWCLK)
/cpu/SWDIO: R328.1, U301.34 (SWDIO)
/cpu/SWD_VCC: J301.1 (VCC), R303.2
/cpu/SWO: J301.6 (SWO_TDO), R316.2, U301.40 (GPIO32)
/cpu/USB_DN: J302.3, J310.A7 (D-), J310.B7 (D-), R301.2
/cpu/USB_DP: J302.2, J310.A6 (D+), J310.B6 (D+), R302.2
/cpu/VERSION_DETECT: R333.1, U301.25 (GPIO24)
/cpu/~BOOTLDR: J308.1, R324.2, SW308.1, SW308.2
GND: C301.2, C302.2, C303.2, C304.2, C305.2, C306.2, C307.2, C308.2, C309.2, C311.2, C312.1, C313.2, C314.2, C315.2, C316.2, C317.2, C318.2, C319.2, C320.2, C321.1, C322.1, C323.1, C324.1, C325.1, CON401.3 (VSS), CON401.6 (VSS), CON401.12 (SHELL1), CON401.13 (SHELL2), D302.1 (K), J301.3 (GND), J301.5 (GND), J301.9 (GNDDetect), J302.4, J303.1, J303.MP (MountPin), J304.2, J305.4, J307.1, J308.2, J309.4, J309.6, J309.8, J310.A1 (GND), J310.A12 (GND), J310.B1 (GND), J310.B12 (GND), J310.S1 (SHIELD), J311.2, J311.MP (MountPin), J312.2, J313.2, J314.6 (VSS), J314.9 (SHIELD), LS301.2, R320.2, R322.2, R332.1, R333.2, SW1.4, SW1.5, SW1.6, SW308.3 (K), SW308.4 (A), SW312.1, SW312.3 (MNT), SW313.3 (K), SW313.4 (A), U301.62 (VREG_PGND), U301.81 (GND), U302.4 (VSS), Y2.2, Y2.4; also elsewhere on the board
I2S_CK: U301.7 (GPIO9); also elsewhere on the board
I2S_SD: U301.9 (GPIO11); also elsewhere on the board
I2S_WS: U301.8 (GPIO10); also elsewhere on the board
unnamed: C315.1, R325.1, Y2.3
unnamed: D302.2 (A), R304.1
unnamed: J304.1, R305.1
unnamed: J306.2, R306.2, R326.1
unnamed: J310.A5 (CC1), R332.2
unnamed: J310.B5 (CC2), R322.1
unnamed: J314.5 (CLK), R336.1
unnamed: J314.3 (CMD), R335.1
unnamed: J314.7 (DAT0), R337.1
unnamed: J314.8 (DAT1), R338.1
unnamed: J314.1 (DAT2), R340.1
unnamed: J314.2 (DAT3/CD), R339.1
unnamed: LS301.1, R306.1
unnamed: R301.1, U301.66 (USB_DM)
unnamed: R302.1, U301.67 (USB_DP)
unnamed: C314.1, U301.30 (XIN), Y2.1
unnamed: R325.2, U301.31 (XOUT)
USB_VCC: J302.1, J310.A4 (VBUS), J310.A9 (VBUS), J310.B4 (VBUS), J310.B9 (VBUS); also elsewhere on the board
WL.CLK: J309.11, U301.1 (GPIO4); also elsewhere on the board
WL.CS: J309.7, U301.79 (GPIO2); also elsewhere on the board
WL.D: J309.5, U301.78 (GPIO1); also elsewhere on the board
WL.ON: J309.3, U301.77 (GPIO0); also elsewhere on the board
~DATA_DIR: U301.22 (GPIO22); also elsewhere on the board
~DBGLOG: R316.1, R331.2, SW1.2
~GPIO_ACK: R317.2, U301.28 (GPIO27); also elsewhere on the board
~GPIO_ATN: U301.3 (GPIO6); also elsewhere on the board
~GPIO_CD_SEL: U301.23 (GPIO23); also elsewhere on the board
~GPIO_DB0: U301.11 (GPIO12); also elsewhere on the board
~GPIO_DB1: U301.12 (GPIO13); also elsewhere on the board
~GPIO_DB2: U301.13 (GPIO14); also elsewhere on the board
~GPIO_DB3: U301.14 (GPIO15); also elsewhere on the board
~GPIO_DB4: U301.16 (GPIO16); also elsewhere on the board
~GPIO_DB5: U301.17 (GPIO17); also elsewhere on the board
~GPIO_DB6: U301.18 (GPIO18); also elsewhere on the board
~GPIO_DB7: U301.19 (GPIO19); also elsewhere on the board
~GPIO_DBP: U301.20 (GPIO20); also elsewhere on the board
~GPIO_IO: U301.4 (GPIO7); also elsewhere on the board
~GPIO_MSG_BSY: U301.27 (GPIO26); also elsewhere on the board
~GPIO_REQ: R318.2, U301.21 (GPIO21); also elsewhere on the board
~INITIATOR: R317.1, R320.1, R321.2, SW1.1; also elsewhere on the board
~IN_RST: U301.57 (GPIO46_ADC6); also elsewhere on the board
~OUT_BSY: U301.56 (GPIO45_ADC5); also elsewhere on the board
~OUT_RST: U301.58 (GPIO47_ADC7); also elsewhere on the board
~OUT_SEL: U301.55 (GPIO44_ADC4); also elsewhere on the board
~TERM_EN: R318.1, R323.2, SW1.3; also elsewhere on the board

Notes on the sheet:
Program/debug interface
Reserved for 8-bit MMC
DIP config
Note: 100R resisitors should be close to the RP2040 pins
SD card interface
I2C interface
DIP switch GPIOs can be reused after switch state has been read. R316-R318 must be strong enough to override 74LVT245 bus hold current 500uA.

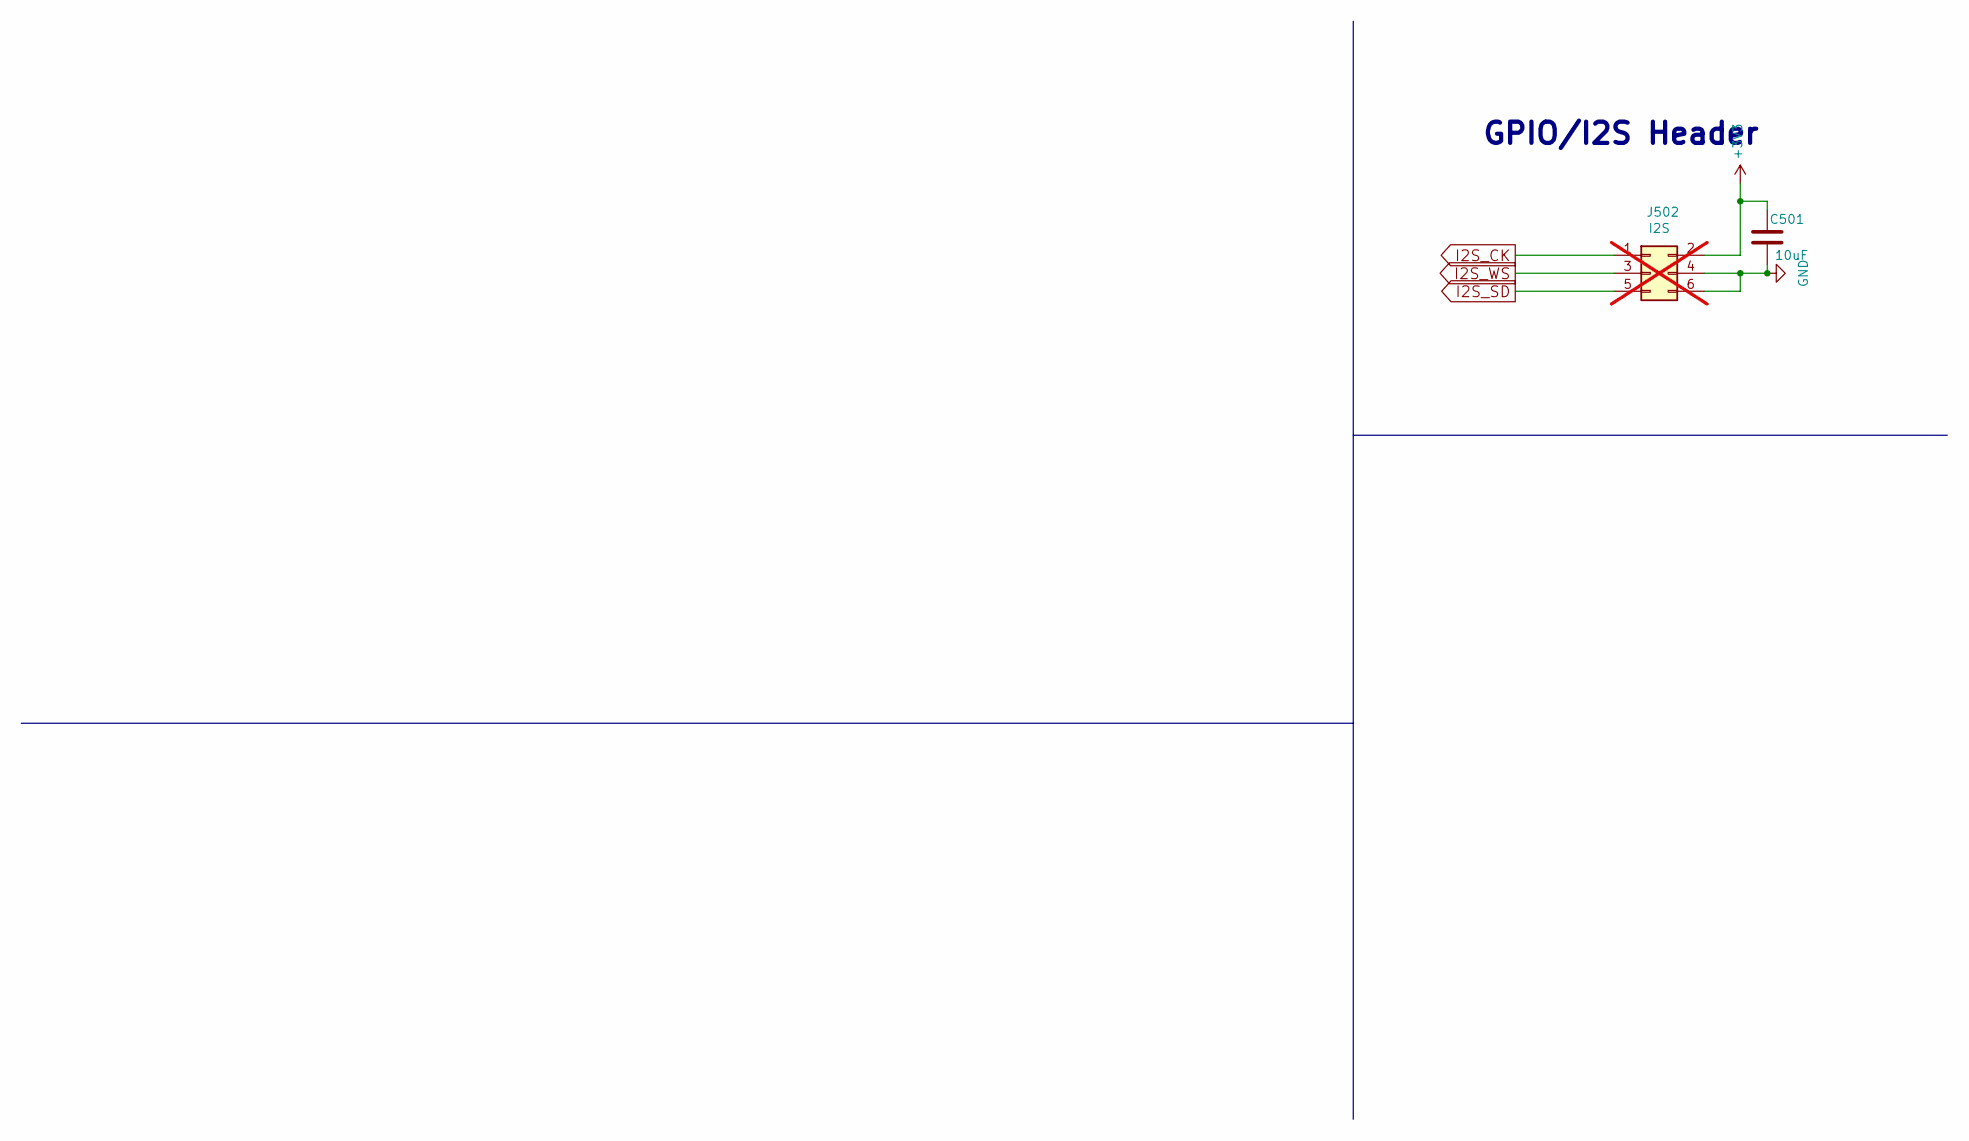
[picture p11: schematic audio-dac.kicad_sch, ZuluSCSI Blaster Ultra Lite OSHW]

Parts:
C501: 10uF; C_0805_2012Metric; PartNumber CL21A106KAYNNNE; LCSC C15850
J502: I2S; PinHeader_2x03_P2.54mm_Vertical; JLCPCB_IGNORE do not fit; not fitted

Connections:
+3V3: C501.1, J502.2; also elsewhere on the board
GND: C501.2, J502.4, J502.6; also elsewhere on the board
I2S_CK: J502.1; also elsewhere on the board
I2S_SD: J502.5; also elsewhere on the board
I2S_WS: J502.3; also elsewhere on the board

Notes on the sheet:
GPIO/I2S Header
