ZuluSCSI/ZuluSCSI-Blaster-Ultra-Lite-OSHW/ZuluSCSI_Blaster_Ultra_Lite.kicad_pcb

## KiCad design ZuluSCSI_Blaster_Ultra_Lite.kicad_pcb (continued)

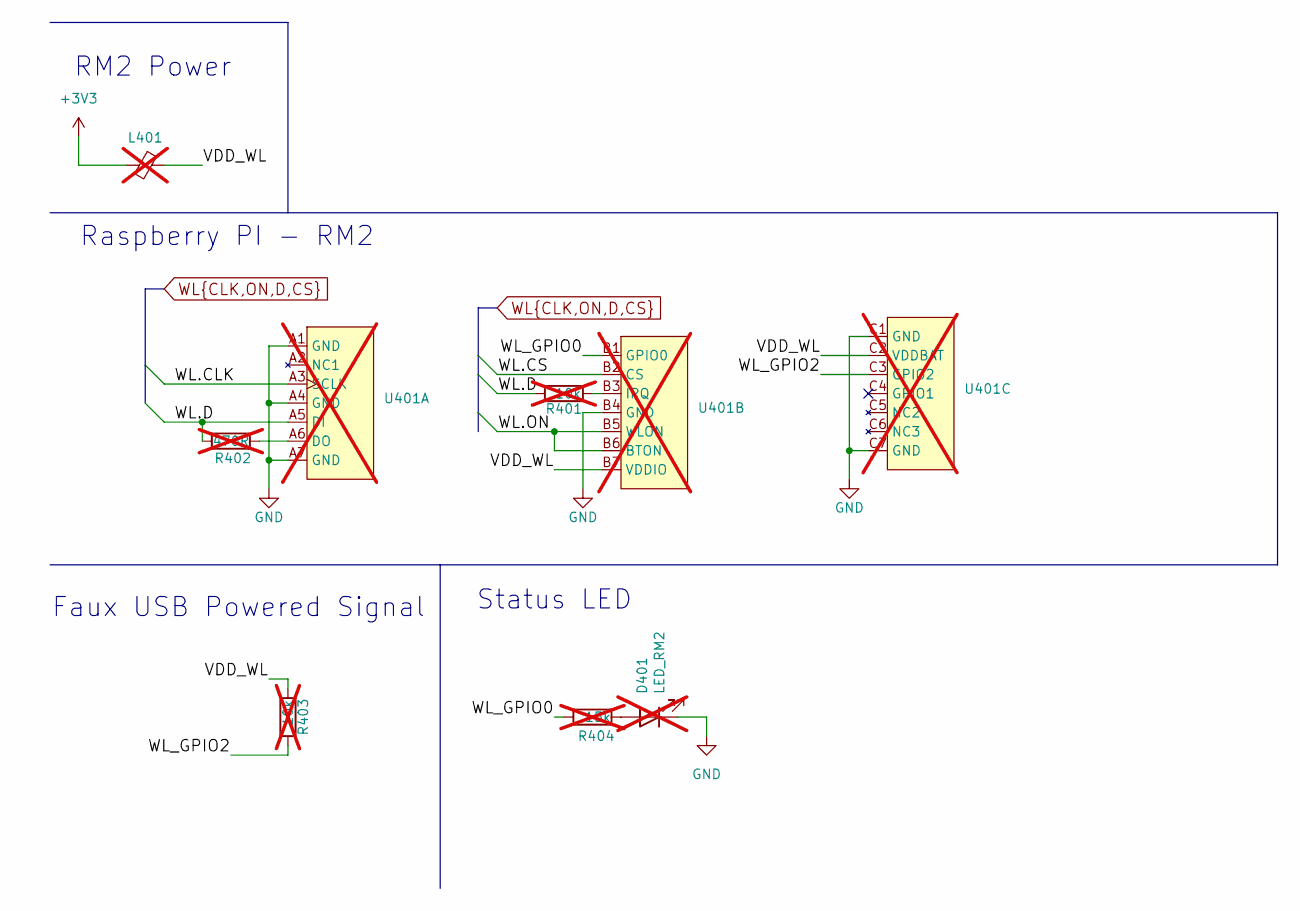
[picture p12: schematic rm2.kicad_sch, ZuluSCSI Blaster Ultra Lite OSHW]

Parts:
D401: LED_RM2; LED_0805_2012Metric; LCSC C2297; not fitted
L401: Ferrite_Bead_Small; L_0603_1608Metric; PartNumber BLM18PG330SN1D; LCSC C88984; not fitted
R401, R403: 10k; R_0603_1608Metric; PartNumber RC0603FR-0710KL; LCSC C25804; not fitted
R402: 470R; R_0603_1608Metric; PartNumber RC0603FR-07470RL; LCSC C23179; not fitted
R404: 15k; R_0603_1608Metric; PartNumber RC0603FR-0715KL; LCSC C22809; not fitted
U401: RPI_RM2; PartNumber RMC20452T; LCSC C49451547; not fitted

Connections:
+3V3: L401.2; also elsewhere on the board
/RM2/VDD_WL: L401.1, R403.2, U401.B7 (VDDIO), U401.C2 (VDDBAT)
/RM2/WL_GPIO0: R404.2, U401.B1 (GPIO0)
/RM2/WL_GPIO2: R403.1, U401.C3 (GPIO2)
GND: D401.1 (K), U401.A1 (GND), U401.A4 (GND), U401.A7 (GND), U401.B4 (GND), U401.C1 (GND), U401.C7 (GND); also elsewhere on the board
unnamed: D401.2 (A), R404.1
unnamed: R402.2, U401.A6 (DO)
unnamed: R401.2, U401.B3 (IRQ)
WL.CLK: U401.A3 (SCLK); also elsewhere on the board
WL.CS: U401.B2 (CS); also elsewhere on the board
WL.D: R401.1, R402.1, U401.A5 (DI); also elsewhere on the board
WL.ON: U401.B5 (WLON), U401.B6 (BTON); also elsewhere on the board

Notes on the sheet:
Faux USB Powered Signal
Raspberry PI - RM2
Status LED
RM2 Power

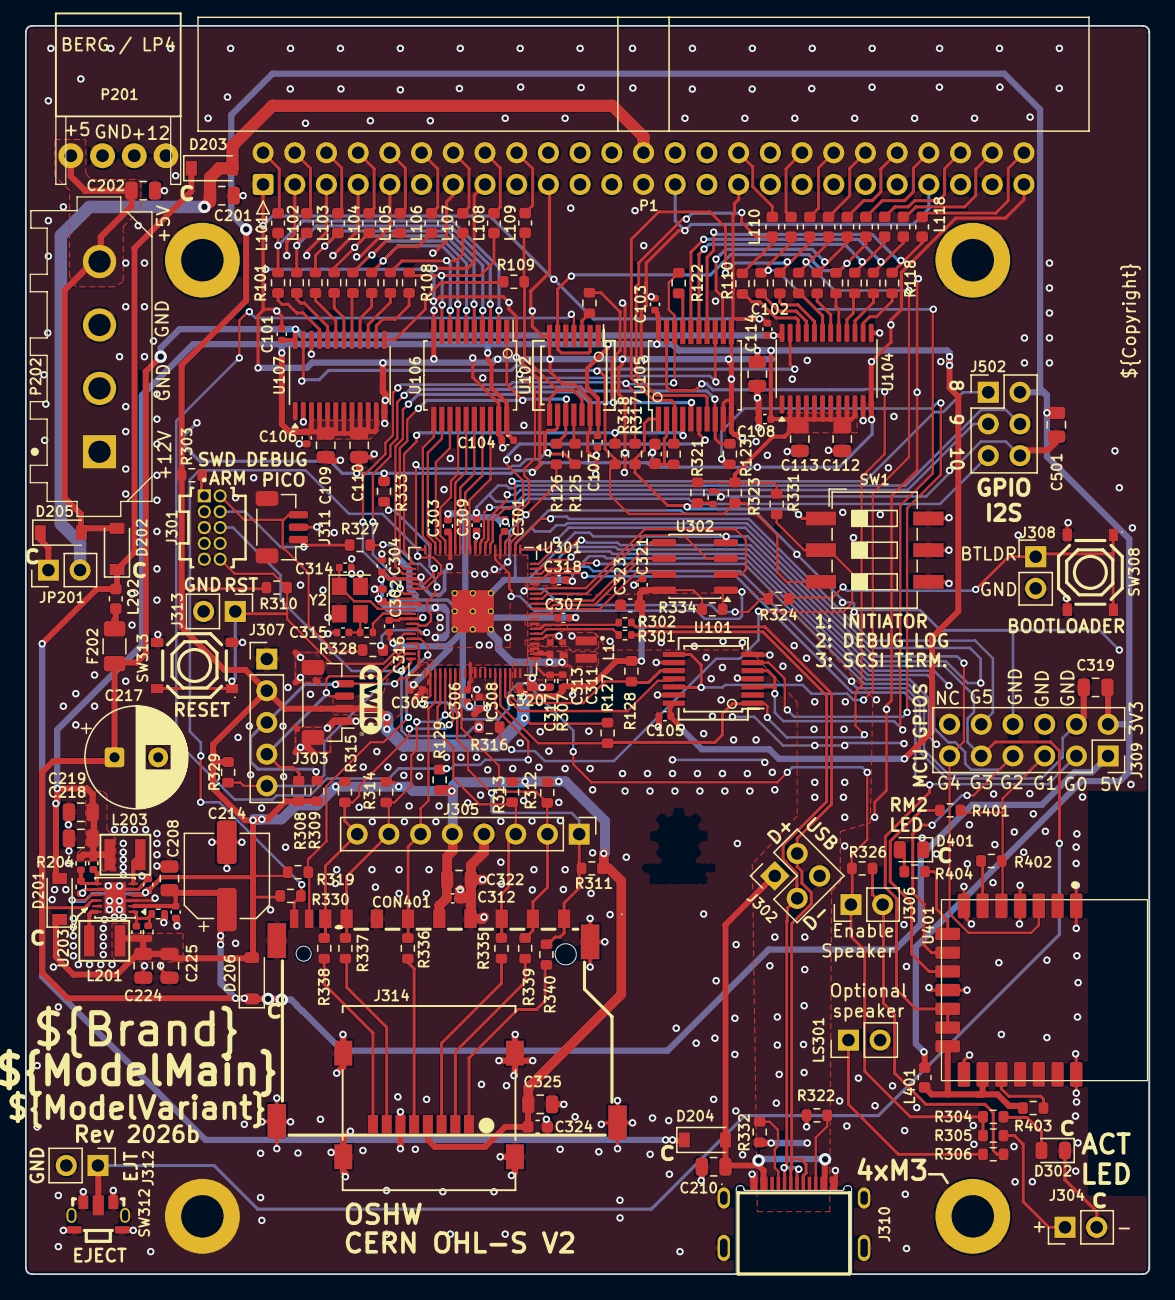
[picture p13: board ZuluSCSI_Blaster_Ultra_Lite.kicad_pcb from above]

Board: 2 copper layers, 90.0 x 100.0 mm, 202 parts (1 on the bottom side), 161 nets.
