ZuluSCSI/ZuluSCSI-Blaster-Ultra-Lite-OSHW/(notices)

Notices in the files:
cpu.kicad_sch:
Copyright 2026 Rabbit Hole Computing
Licensed under CERN OHL-S V2
parts and their libraries:
Copyright: ©2026 Rabbit Hole Computing LLC
